MakeMagazinDE/Hydroponik-mit-Arduino/README.md

GitHub Logo

Maker Media GmbH
*** 

# Hydroponik-mit-Arduino
Arduino züchtet Salat

### Mit einem Ikea-Hack und einer Arduino-Steuerung kann man den Salatanbau ganz einfach automatisieren. Diese Hydroponikanlage ist mobil, modular, wartungsarm und ausfallsicher. 

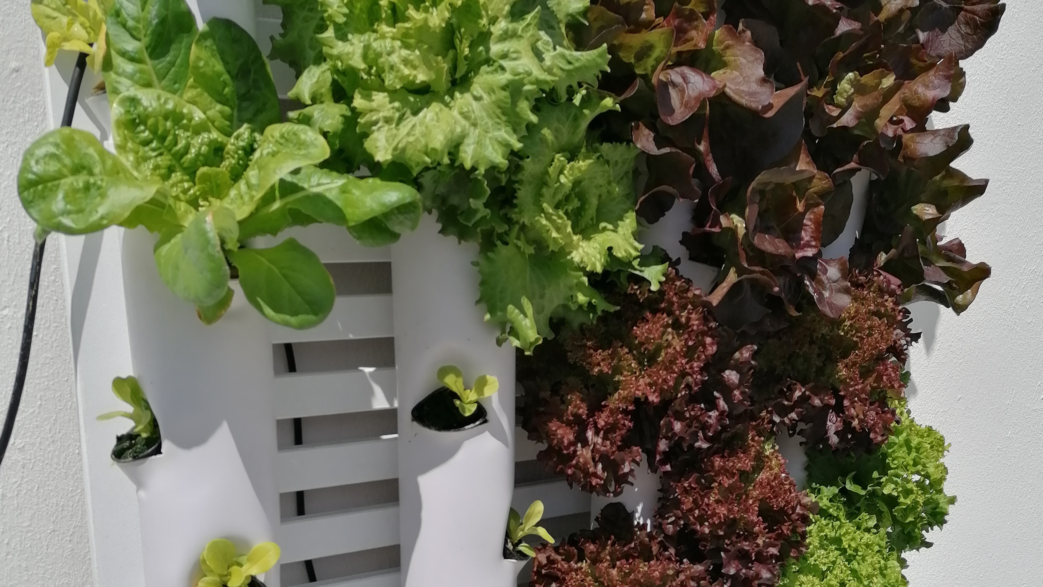
[picture p1: hydroponik.jpg]


Den vollständigen Artikel mit der Bauanleitung gibt es in der [Make-Ausgabe 2/2021](https://www.heise.de/select/make/2021/2/2023018371963195365) zu lesen.
