MakeMagazinDE/Hydroponik-mit-Arduino/masse.jpg

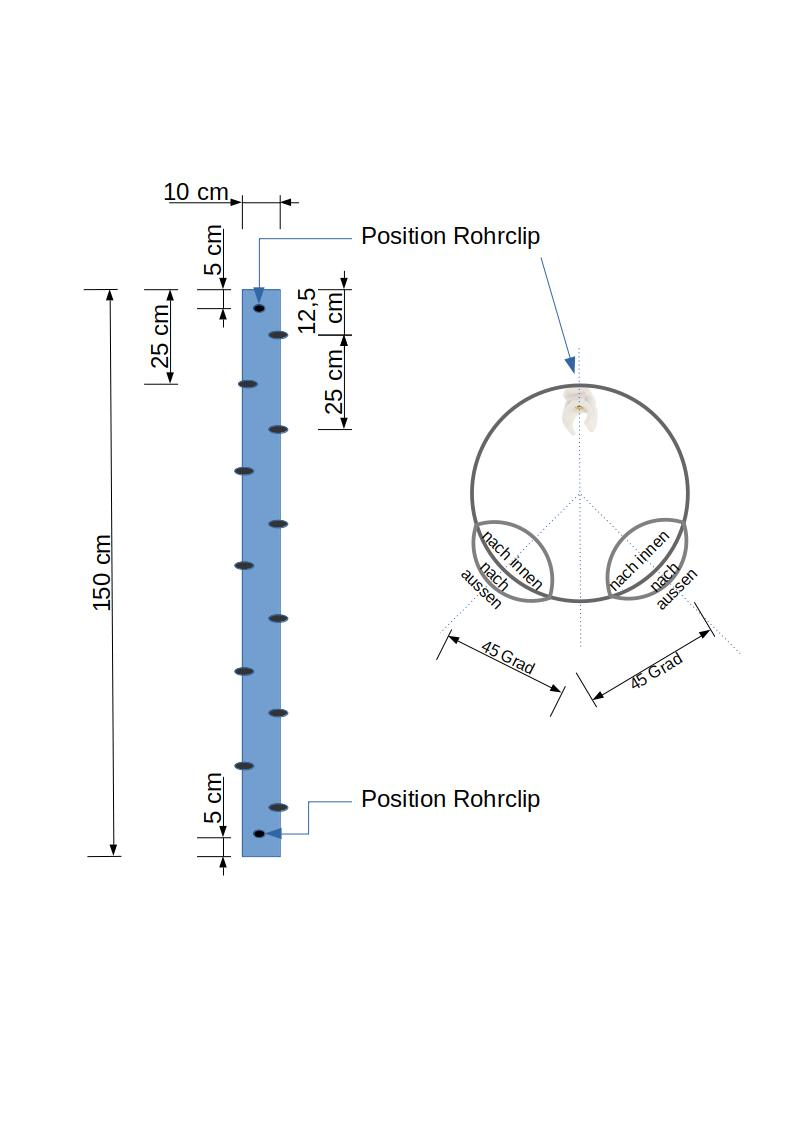
masse.jpg
