MakeMagazinDE/Hydroponik-mit-Arduino/Salat2_Steckplatine.jpg

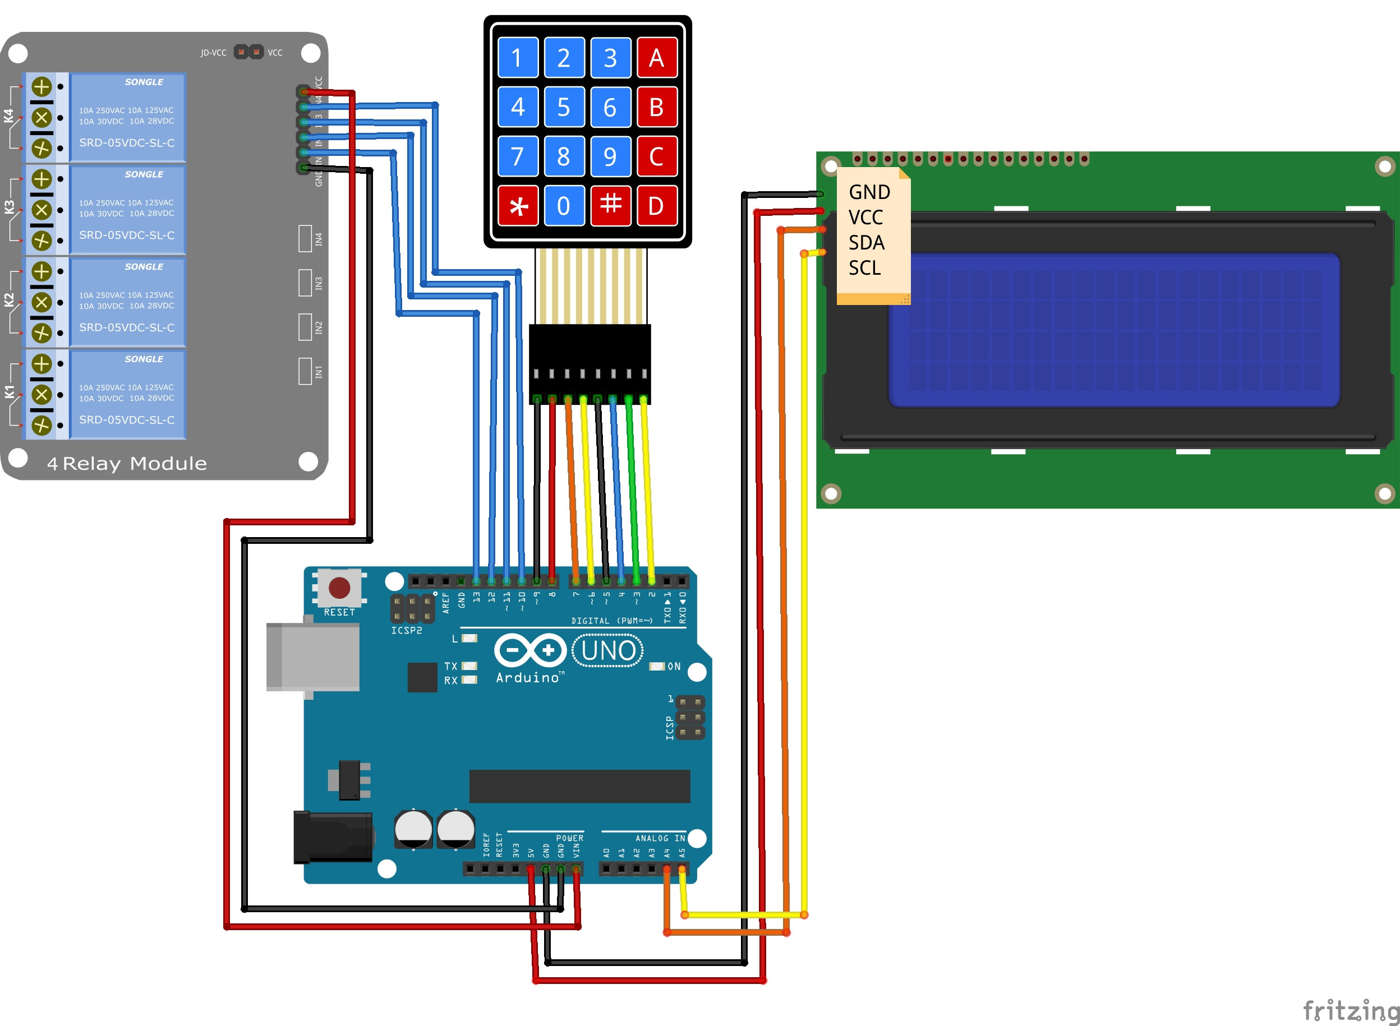
Salat2_Steckplatine.jpg
