MakeMagazinDE/Hydroponik-mit-Arduino/schematisch.jpg

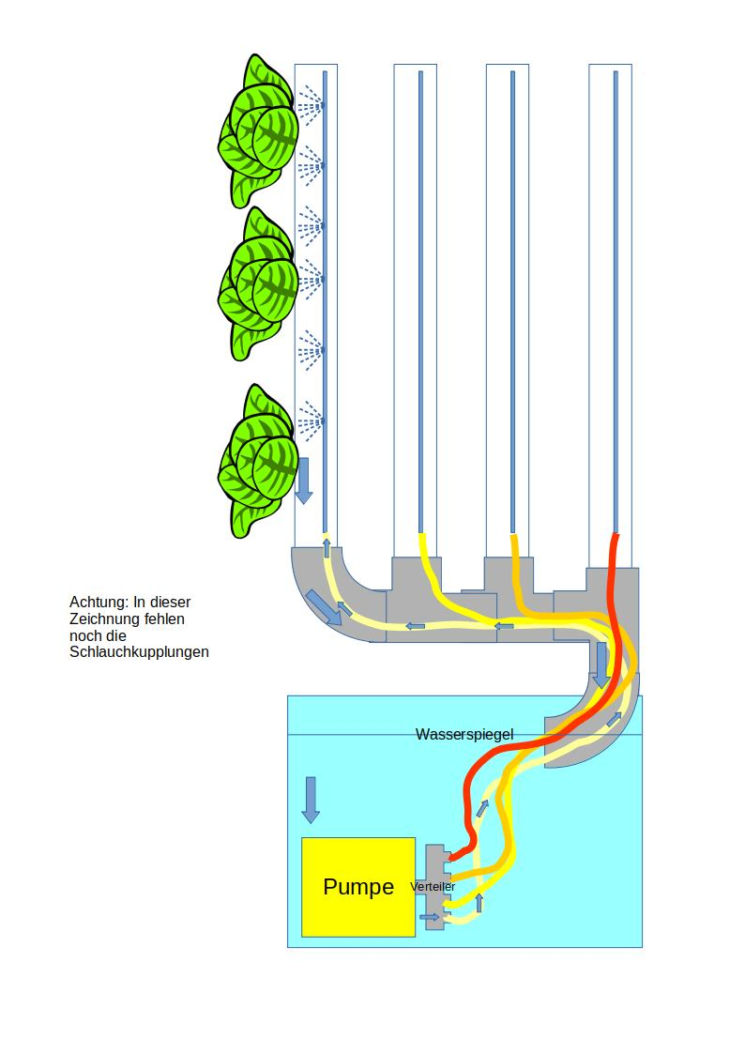
schematisch.jpg
