MakeMagazinDE/Hydroponik-mit-Arduino/Hydroponik_Materialliste.txt

1x ÄPPLARÖ Banktruhe
1x ÄPPLARÖ Wandpaneel
4x Schwerlastrollen lenkbar, evtl. arretierbar, ca.
2x Regalwandschienen zur Verstärkung und Montage des Paneel, 150cm, ca.
1x Teichfolie 1,5 x 2,0 Meter, ca
Parkett- und Laminatunterlage 0,3 cm
4x PVC Lüftungsrohr 100mm 
4x Elektrorohr 16mm
8x Rohrclips mit Gewinde, passend zum Elektrorohr (16/18mm)
2x Abwasserrohr, 90Grad Winkel DN110
3x Abwasserrohr, HT-Abzweig DN110
4x PVC Rohrschelle für 100mm Lüftungsrohr 
4x Muffenstopfen DN110
1x Wasserverteiler 4fach, mit Reglern
4x Schlauchverbinder male-male, ca.
12x Schlauchkupplung female
2x Rohrschelle 4 Zoll (für 100-110mm Rohre) mit Gewindebuchse
1x Tauchpumpe, ab 4000l/h
1x Schaltschrank IP65 Industriegehäuse 20x30x13cm

Holzbrett für Bodenverstärkung,
2 x Kantholz (ca. 37x4x6cm) zur Befestigung der Rollen
Holzleiste für Befestigung von losen Latten am Deckel
Weiße Farbe zum Anstreichen derTruhe und des Paneels
Weiße Farbe für die grauen DN-Komponenten (wasserbasierter Acryllack hält nicht!)
Holzkeil/Plastikrohr für Lochlehre
Gartenschlauch, ca 6m
Gitternetztöpfe (billig+flexibel) 100 Stück
