MakeMagazinDE/Hydroponik-mit-Arduino/(threads)

Thread 2 (2021-06-03):

Frage von komplettem Arduino Neuling

admindonkey, 2021-06-03:
Hi,

vielen Dank für die interessante Idee mit der Salatmaschine.
Ich bin dabei das Projekt selbst auch zu bauen.
Hab ich das richtig verstanden, Den Code muss ich in die Arduino App laden und auf das Gerät schreiben, oder?
Bei mir meckert er gleich Keypad.h: No such file or directory.
Was mache ich falsch?

Grüße

G1urp, 2021-06-05:
Hallo,

mit den fehlenden Angaben über die einzubindenden Bibliotheken bin ich auch gestolpert.

die Keypad.h steckt in der Bibliothek "Keypad" (https://github.com/Chris--A/Keypad)
bei LiquidCrystal_I2C.h ist die Bibliothek "LiquidCrystal I2C"  (by Marco Schwartz https://github.com/johnrickman/LiquidCrystal_I2C) nötig

Wenn du meinen Fork benutzt sind noch die letzten Stolpersteine behoben (eine falsch deklarierte Variable und ein Fehler bei der Nutzung der LiquidCrystal_I2C Klasse. Die Details kannst du über die Commits nachvollziehen.

Grüße

admindonkey, 2021-06-06:
Hi,

vielen Dank für deinen Tipp. Ich probiere es mal aus, auch wenn ich das mit
der Fork und den Commits noch nicht so ganz geblickt habe 😁

Grüße und einen schönen Sonntag

Günter

G1urp ***@***.***> schrieb am Sa., 5. Juni 2021, 14:30:

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

admindonkey, 2021-06-06:
Das mit den Bibliotheken hat jetzt (glaube ich geklappt)
Jetzt kommt diese Fehlermeldung:

Hydroponik:32:1: error: 'Keypad' does not name a type; did you mean 'Key'?
 Keypad Tastenfeld = Keypad(makeKeymap(hexaKeys), rowPins, colPins, ROWS, COLS);
 ^~~~~~
 Key

Hast du evtl. noch eine Idee?

admindonkey, 2021-06-07:
Jetzt hat es geklappt.

den kompletten Ordner von https://github.com/Chris--A/Keypad und https://github.com/johnrickman/LiquidCrystal_I2C
in den Ordner ...\Arduino\libraries kopieren.
Wenn man es weiß, wie es geht ist es einfach :o)

admindonkey, 2021-06-07:
Nun stehe ich allerdings vor dem nächsten Problem.
Das Display leuchtet und geht nach einer gewissen Zeit aus.
Allerdings wird nichts angezeigt.
Hast du hier vielleicht wieder eine Idee?

Thread 4 (2021-06-20):

mein erstes Make Projekt

jstuk, 2021-06-20:
Hallo,

Ich muss sagen, der physische Part des Projektes ist sehr gut und detailliert beschrieben. Was dann die Verkabelung aller Komponenten und Erfahrungen mit Einstellungen in der Steuerung betrifft, wurde sehr gespart, zumindest aus der Sicht eines Neulings. Gibt es zu dem Teil der Steuerung noch eine genauere Einkaufsliste und ein Schema der kompletten elektrischen/elektronischen Verkabelung? Habt Ihr Erfahrungsberichte mit der Einstellung der Bewässerung, die Ihr teilen könnt?

G1urp, 2021-06-23:
Hallo auch zurück,

der Niederspannungsteil erscheint mir ausreichend dokumentiert. Wenn es dazu spezielle Fragen gibt werden diese mit Sicherheit beantwortet. Für den 240VAC Teil hilft hoffentlich die kleine Zeichnung weiter:

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

Beim Aufbau bitte berücksichtigen das 240VAC keine Schutzkleinspannung mehr ist! Es sollten geeignete und gegen unbeabsichtiges Berühren geschützte Klemmen verwendet werden. Der Leitungsquerschnitt ist auch mit 0,75 mm^2 aufwärts auszulegen, je nach Leitungslänge und Leitungsschutzschalter im "Sicherungskasten". Mit 2.5mm^2 ist man im Hausbereich auf der sichern Seite. Wenn die Leitung im Kurzschlussfall zu heiß wird und die Isolation anfängt zu "weinen" ist definitiv was faul. Das bei flexiblen Leitungen die Enden mit Adernendhülsen verpresst werden oder passende Klemmen verwendet werden versteht sich von selbst. Die Anschlüsse des Relais-Board sind nicht für lose Litze geeignet. Es soll auch schon Leute gegeben haben die solche Enden mit dem Lötkolben verzinnt haben ... macht hoffentlich niemand ;-)

Diese Einkaufsliste wird ihnen von Reichelt.de präsentiert:

Artikelnummer           Bezeichnung

ARDUINO UNO          Arduino Uno Rev3, SMD-Variante, ATmega328, USB
DEBO RELAIS 4CH      Entwicklerboards - Relais-Modul, 4 Channel, 5V, SRD-05VDC-SL-C
DEBO LCD 20X4 BL     Entwicklerboards - Display, 20 x 4 Zeichen, blau
DEBO TAST 4X4          Entwicklerboards - Folientastatur, 4 x 4 Ziffern
EL FRB SKDO2W         AP-Feuchtraum-Steckdose, 2-fach, wagerecht

(eventuell auch hilfreich)
SL 1X40G 2,45            40pol. Stiftleiste, gerade, RM 2,45
MW 3K10GS              Universal-Schaltnetzteil, 12 W, 3 - 12 V, 1000 mA

Besser geeignet erscheint ein Handy Netzteil mit USB A-B Kabel. Egal welches Netzteil Verwendung findet die Steckdosen (wenn wie oben verschaltet) sind dafür nicht nutzbar!

Gardena Pumpen waren hier im Hornbach nicht verfügbar deshalb fiel die Wahl auf eine Einhell GC-DP 3730 (hoffentlich ist die nicht zu laut). Diesen Schaltschrank aus dem Artikel bekommt man leider nicht bei Reichelt (oder ich war blind) Deshalb wurde alles erst mal in ein BOPLA M 2401 G gequetscht.

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

Mit Einstellwerten kann ich leider noch nicht dienen. Vom Bauchgefühl her erscheinen die Standardwerte in Bezug auf die Schalthäufigkeit unpassend. Ich lasse mich aber gern eines Besseren belehren und immerhin hat der Autor schon eine Saison Erfahrung.

So weit erst mal (bitte nicht schlagen wenn sich Fehler eingeschlichen haben)
