MakeMagazinDE/Hydroponik-mit-Arduino/(commit log)

2021-04-06 Added arduino code
2021-04-06 Added Materialliste
2021-04-06 Added Schema und Maße
2021-05-31 fix variable declaration wet-time-left
    [Hydroponik.ino]
